ruxia-TJY/TKeyboard/README.md

# TKeyboard

暂时使用Pro Micro(Mini接口)开发板，等到芯片价格降下去，直接使用32u4贴上去缩小体积。

共计两个版本（两个玩具），具体内容详见相关文件夹的文档。

原件焊接信息见bom文件夹下文件

## 预览图

+ 版本一：[TKeyboard](./TKeyboard)

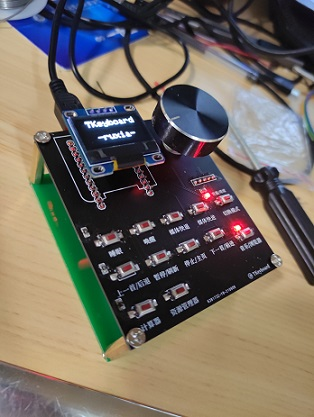
[picture p1: TKeyboard/Preview/TKeyboard.png]


+ 版本二：[TKeyboard2(开发中)](./TKeyboard2)
