ruxia-TJY/TKeyboard/TKeyboard2/Resource/键位.dxf

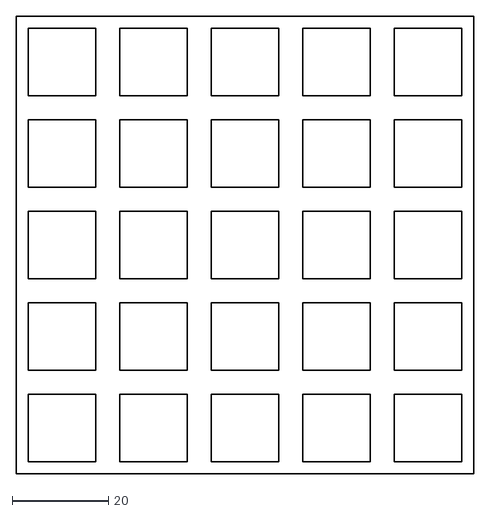
[picture p6: CAD file, 2021-08-30]
TKeyboard2/Resource/键位.dxf
95.3 x 95.2
