ruxia-TJY/TKeyboard/TKeyboard2/Schematic/V0.3/Schematic_TKeyboard2_2021-07-30.pdf

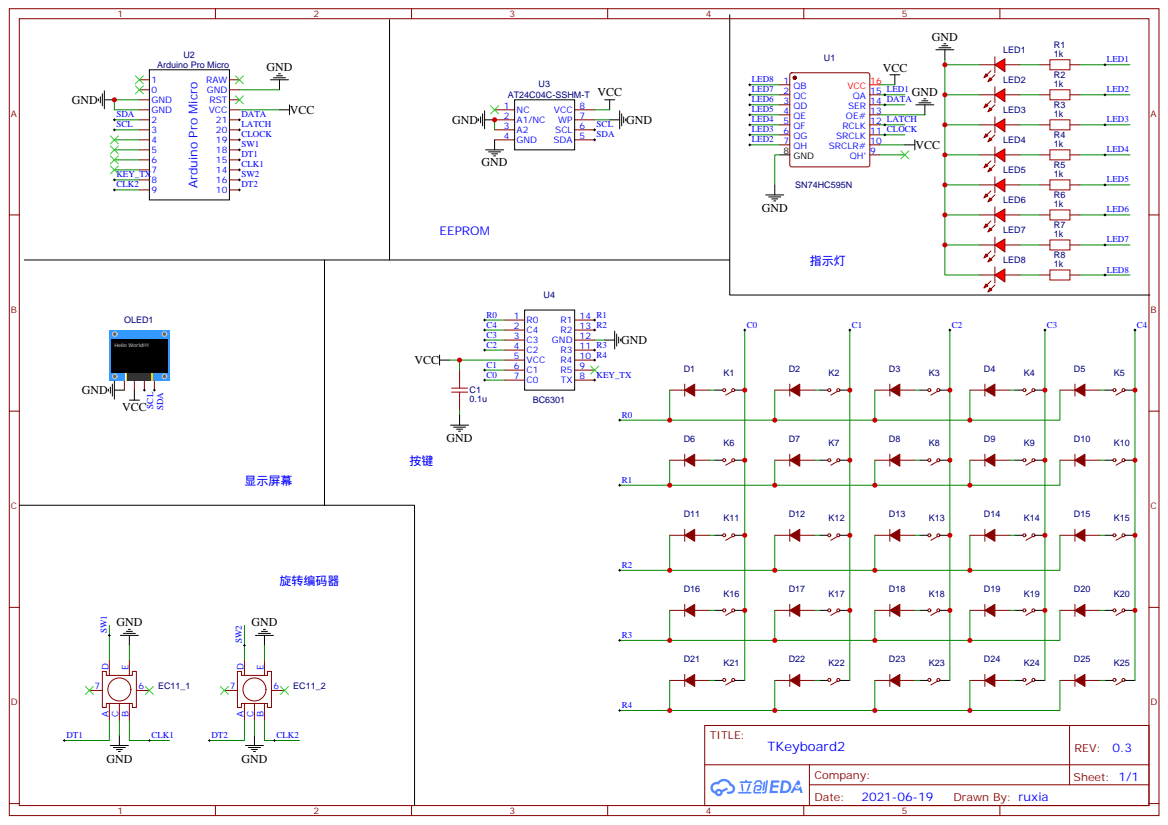
[picture p7: page 1]

SRCLR# 10 SRCLK 11 RCLK 12 OE# 13 SER 14 QA 15 VCC 16
