ruxia-TJY/TKeyboard/TKeyboard/Schematic/V0.2/Schematic_TKeyboard_2021-06-17.pdf

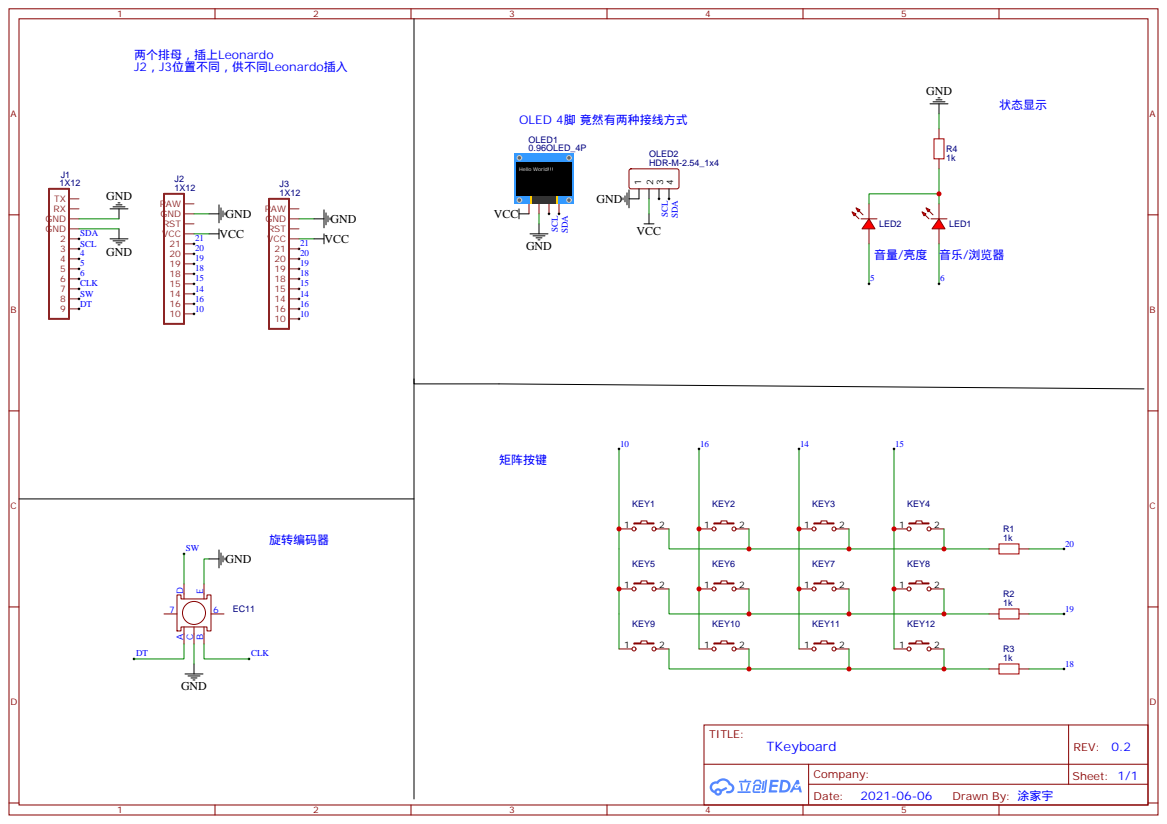
[picture p8: page 1]
