ruxia-TJY/TKeyboard/(list of files, drawings)

Other design files:
Schematic/PCB_TKeyboard_2021-06-10.json
TKeyboard2/Schematic/V0.3/PCB_PCB_TKeyboard2_2021-07-30.json
TKeyboard2/Schematic/V0.3/PCB_TKeyboard2_2021-07-30.pcbdoc
TKeyboard2/Schematic/V0.3/SCH_TKeyboard2_2021-07-30.json
TKeyboard2/Schematic/V0.3/TKeyboard2_2021-07-30.schdoc
TKeyboard/Schematic/V0.2/PCB_TKeyboard floor_2021-06-17.json
TKeyboard/Schematic/V0.2/PCB_TKeyboard floor_2021-06-17.pcbdoc
TKeyboard/Schematic/V0.2/PCB_TKeyboard_2021-06-17.json
TKeyboard/Schematic/V0.2/PCB_TKeyboard_2021-06-17.pcbdoc
TKeyboard/Schematic/V0.2/TKeyboard_2021-06-17.schdoc
