ruxia-TJY/TKeyboard/(commit log)

2021-06-10 第一次添加以及修改
    [PCB_TKeyboard_2021-06-10.json, PCB_TKeyboard_2021-06-10.pcbdoc, TKeyboard_2021-06-10.schdoc]
2021-06-10 修改README
2021-06-15 初始成品
2021-06-27 无意义的修改
2021-08-01 添加TKeyboard2
    [PCB_PCB_TKeyboard2_2021-07-30.json, PCB_TKeyboard floor_2021-06-17.json, PCB_TKeyboard floor_2021-06-17.pcbdoc, PCB_TKeyboard2_2021-07-30.pcbdoc, PCB_TKeyboard_2021-06-17.json, PCB_TKeyboard_2021-06-17.pcbdoc, SCH_TKeyboard2_2021-07-30.json, TKeyboard2_2021-07-30.schdoc]
2021-08-01 修改READM
2021-08-03 初步完成
2021-08-03 修改部分
2021-08-30 添加键位文件
    [键位.dxf]
2022-04-13 修改代码逻
